EyezGlazed/nfc-tap-plate/assets/parts/plate_base.stl

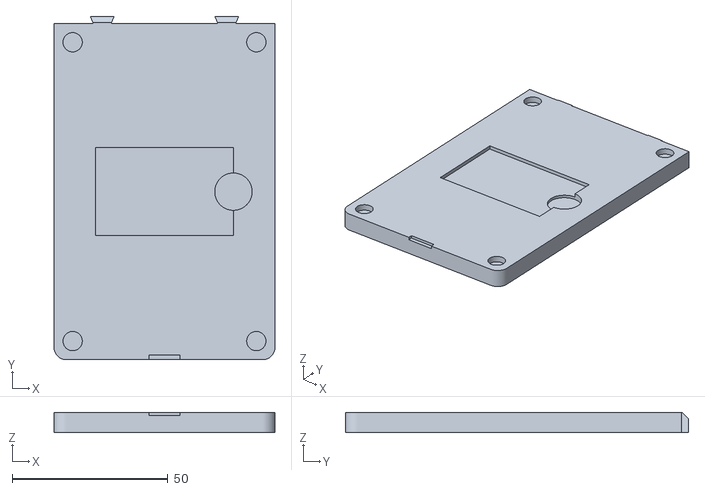
[picture p1: CAD file, 2026-11-03]
assets/parts/plate_base.stl
71.0 x 110.4 x 6.50
