EyezGlazed/nfc-tap-plate/assets/parts/latch.stl

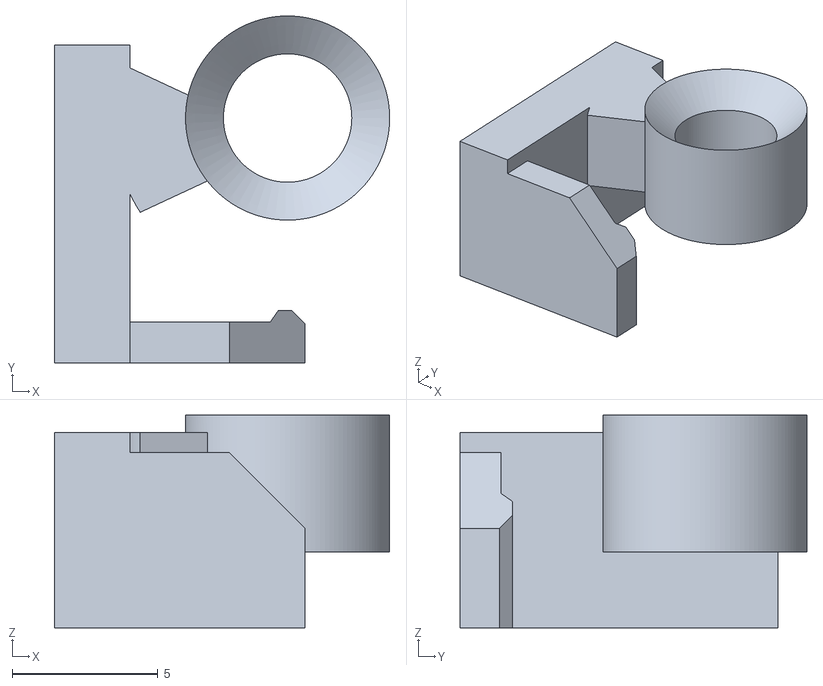
[picture p2: CAD file, 2026-11-03]
assets/parts/latch.stl
11.5 x 11.9 x 7.30
