EyezGlazed/nfc-tap-plate/assets/parts/frame_b.stl

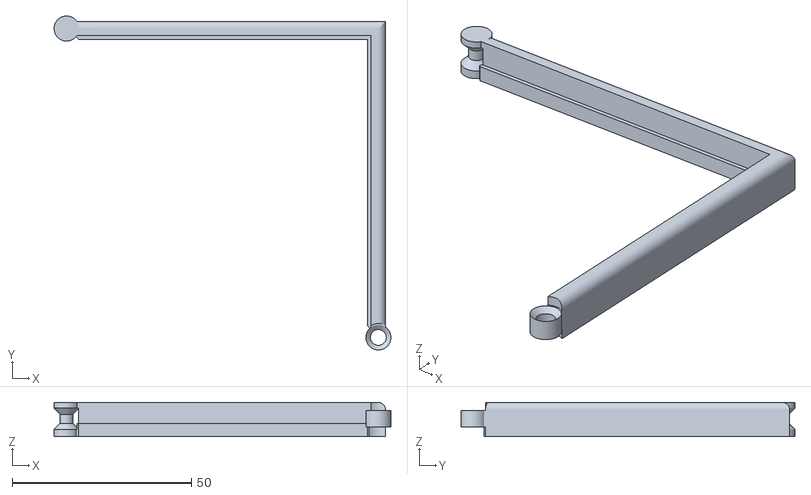
[picture p3: CAD file, 2026-11-03]
assets/parts/frame_b.stl
94.0 x 93.2 x 9.50
