EyezGlazed/nfc-tap-plate/assets/parts/frame_a.stl

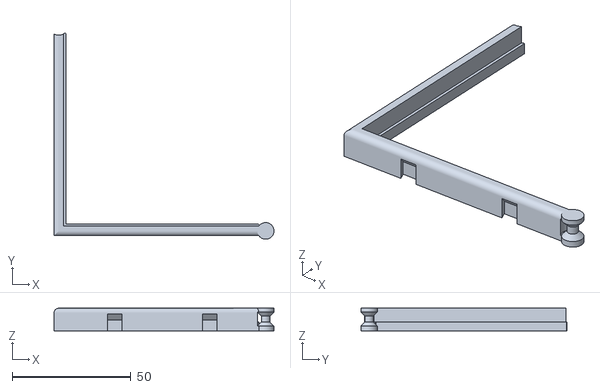
[picture p4: CAD file, 2026-11-03]
assets/parts/frame_a.stl
92.5 x 86.8 x 9.50
