EyezGlazed/nfc-tap-plate/(commit log)

2026-11-03 NFC Tap Plate: browser customizer for a light-switch frame with a magnetic NFC tag plate
    - Front design: logo and icon from any SVG (strokes, knock-outs), frame ring that
    follows the sticker, 0-3 text rows above/below centred in their space.
    - Adjustable switch cover (size, inward lip / outward recess / none) by stretching
    the print-tested frame; sticker pocket presets (rectangular and round).
    - Cover rebuilt with manifold-3d; three.js preview; one-file 3MF export with
    Bambu/Orca/Creality extras (filament per part, first-layer height range).
    - Node tests against the CAD model.
    Code: MIT. Models: CC BY-NC 4.0.
    Claude-Session: htt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
    [frame_a.stl, frame_b.stl, latch.stl, plate_base.stl]
2026-11-03 Frame height: shrink by one slice, min 82.2 -> ~10.5 mm
    The old y shrink cut at +-25 on both sides, so the bottom cut ran into the
    latch window after 9 mm and capped the height at 64.2. Now the height is
    shrunk by removing a single slice from the middle of model.frame.band_y,
    where both side bars are prismatic, then re-centring. Hinge and latch are
    untouched; tests cover 83 x 60 and 56 x 12.
    Claude-Session: https://claude.ai/code/session_01SjJ4tQBr8vGjjZbVP5XJqJ
2026-11-03 Narrower frames, plate notch for latch, grey frame, contrast-safe tag outline
    - Width below 55: a slice from the middle of the top and bottom bars moves the
    dovetail grooves inward; the plate's tongues move to match (min ~28 wide).
    - Fix: below ~73 wide the bottom-left knuckle and the latch overlapped the
    plate's top-left corner. Plate and cover now get a notch covering the
    knuckle and the latch sweep (closed to 45 deg open) with hinge clearance;
    a magnet too close to the notch moves down (base pocket refilled/recut,
    cover follows).
    - Preview: separate frame colour, default #adadad.
    - Tag outline colour meets WCAG AAA against the plate where possible
    (motif second), AA where AAA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
2026-11-03 Per-element colours with one filament per colour; grey/black defaults
    - Colour picker in each section: frame, plate, logo, frame around the logo,
    icon, text below, text above. Defaults: #adadad frame and plate, black motif.
    - The motif splits into one part per distinct colour (cover, preview and
    3MF); filament slots are numbered per colour and listed under Export.
    - Tag outline contrast now checks every motif colour.
    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
2026-11-03 Frame mirrored: latch top-left, hinge bottom-right
    Re-exported from the CAD master, where the frame is now mirrored top to
    bottom (user decision). On narrow frames the latch no longer swings over
    the plate: the notch shrinks to the bottom-right knuckle (max ~11 mm2,
    1.9 deep) instead of 5.8 deep into the magnet pocket.
    - model.frame.T / .Q give the hinge corners; buildFrame takes model.latch
    (print_angle -45 = clockwise opens) and nothing hard-codes the corners.
    - band_y re-measured for the mirrored side bars: [-38.5, 34].
    - Plate notch: A and B parts below the plate edge, B swinging open about T
    (20 deg) and the latch sweep; skipped while the frame is wider than the
    plate.
    - Fix: the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
    [frame_a.stl, frame_b.stl, latch.stl, plate_base.stl]
2026-11-03 Fix Shift + middle drag: map it to ROTATE, which OrbitControls turns into PAN with Shift
    OrbitControls swaps rotate and pan while Shift is held, so mapping the middle
    button to PAN under Shift produced a rotate.
    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
2026-11-03 Width/height inputs: minimums 28 and 10.2 to match what the frame can do now
    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
2026-11-05 Reset button: back to the default settings
    Asks first, then restores the defaults and drops the stored state, the
    uploaded logo, icon and font, and any settings in the link.
    Claude-Session: https://claude.ai/code/session_01SjJ4tPm2tvcEujWipXamPA
